JorisBar/555_Synth/555_Synth.kicad_pcb

## KiCad design 555_Synth.kicad_pcb (2025-11-21)

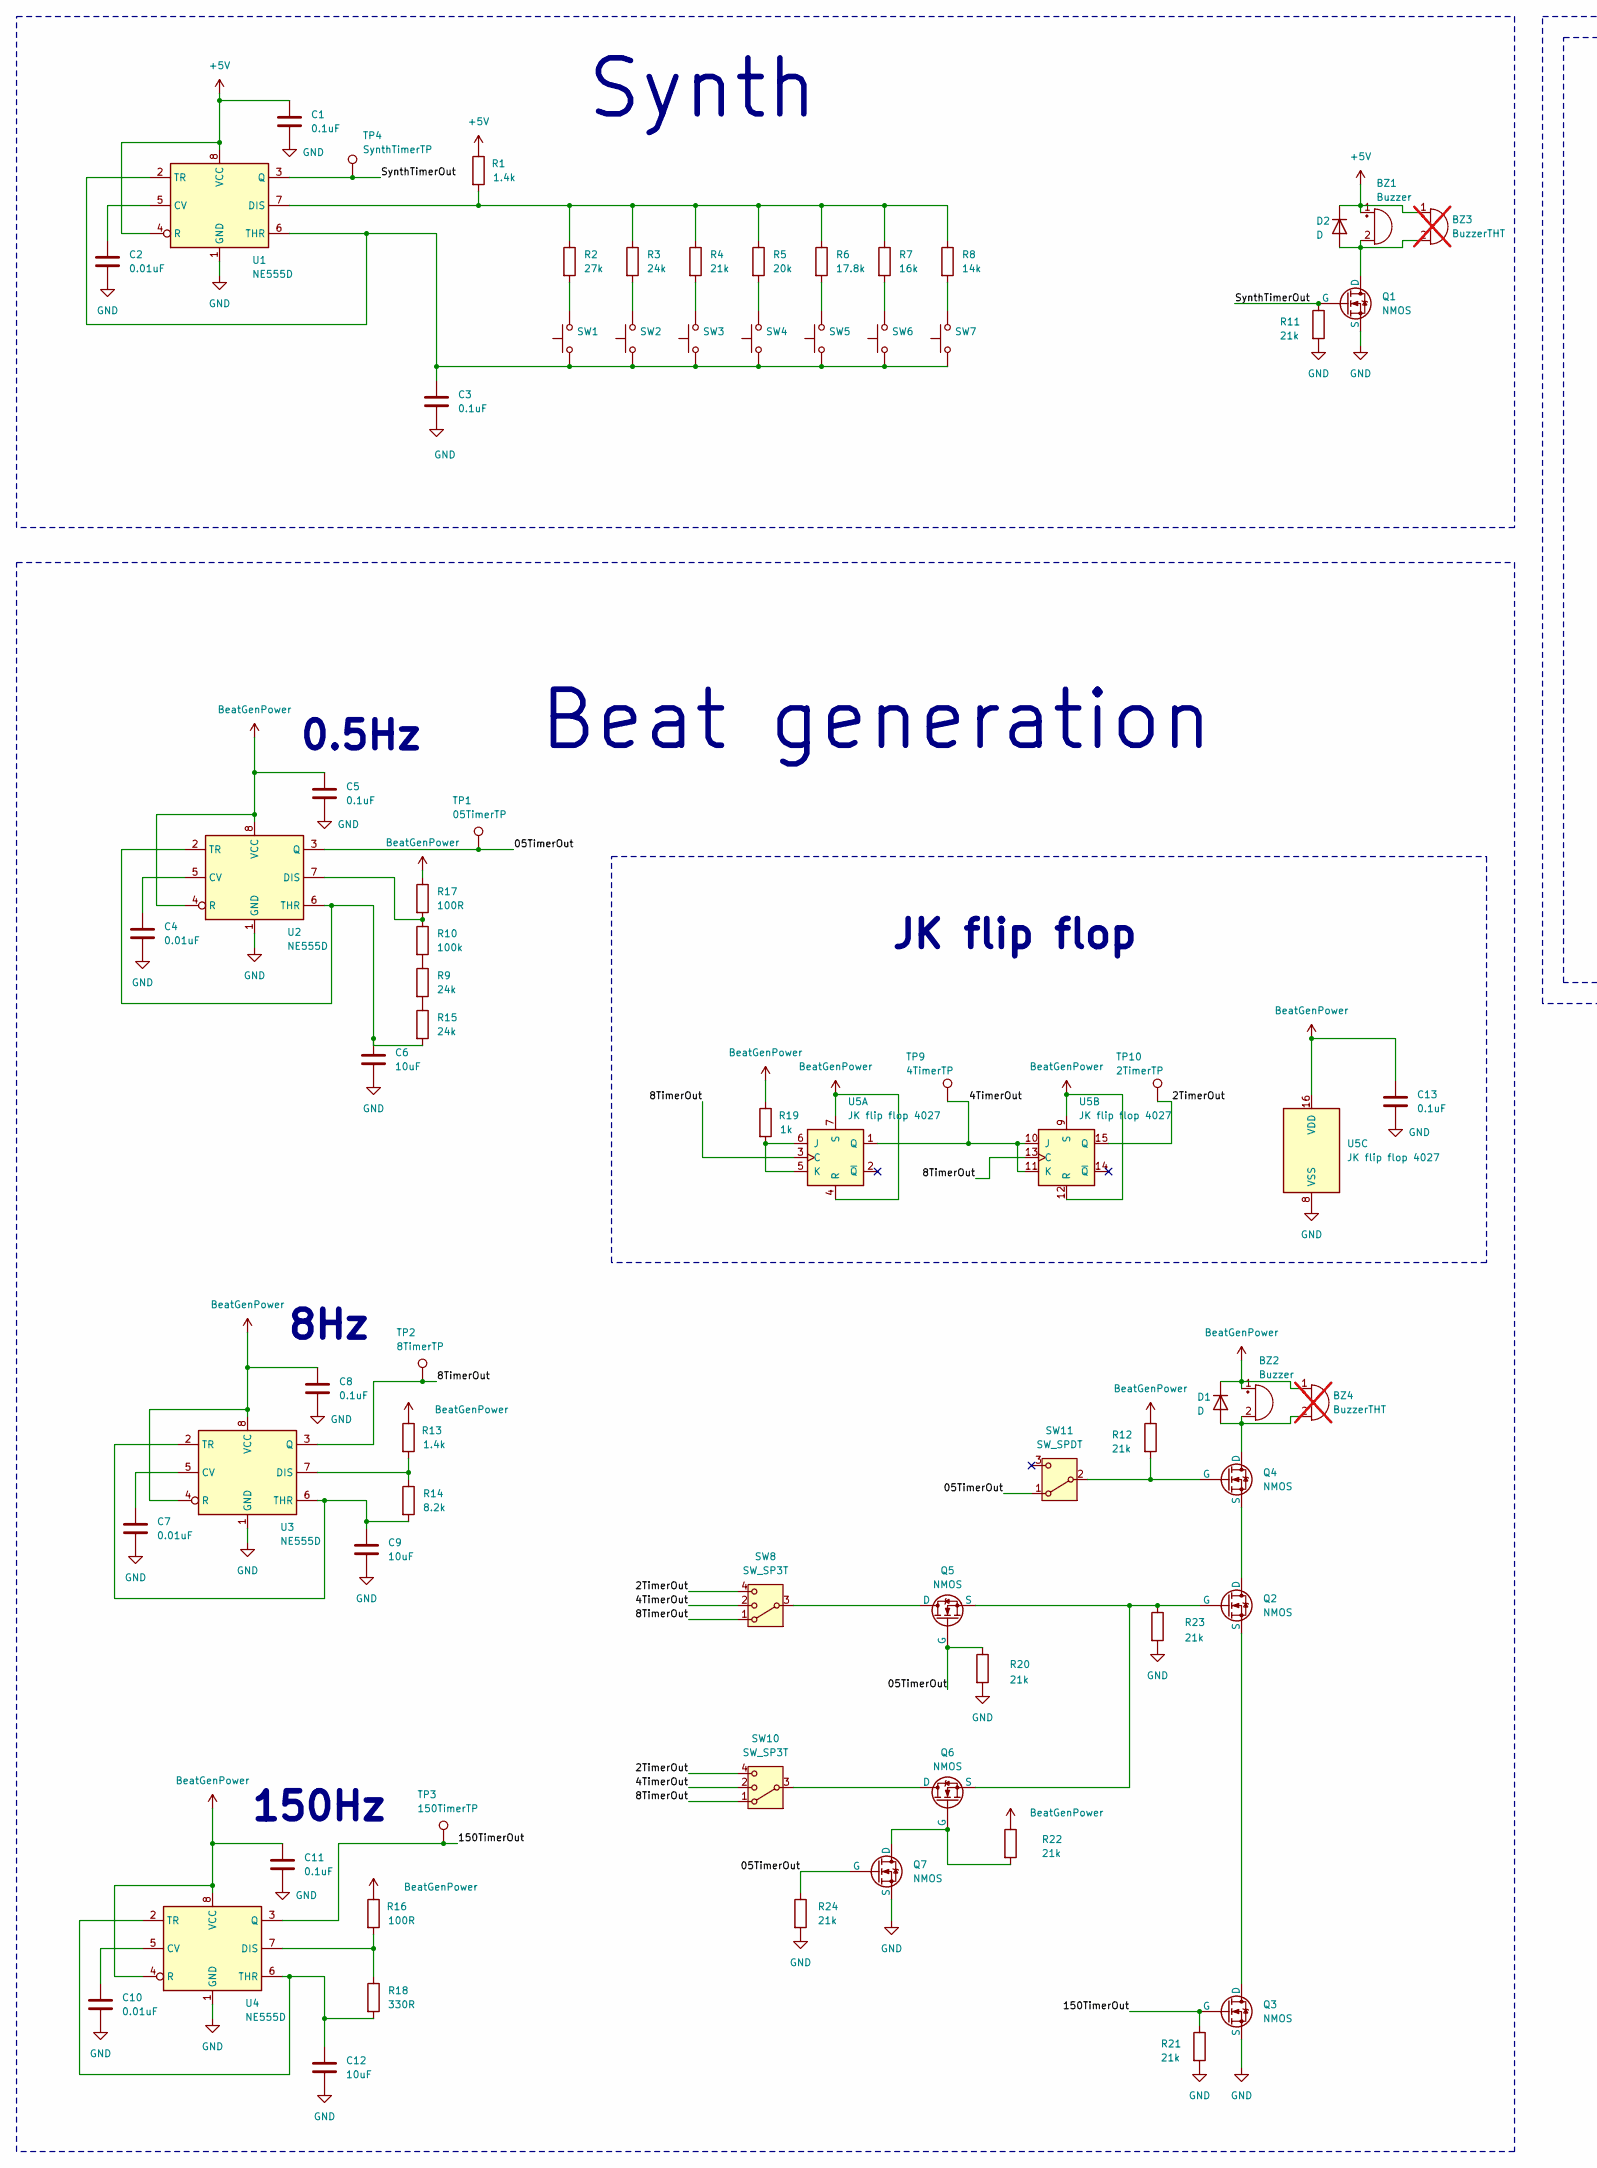
[picture p1: schematic 555_Synth.kicad_sch, part in row 1, column 1]

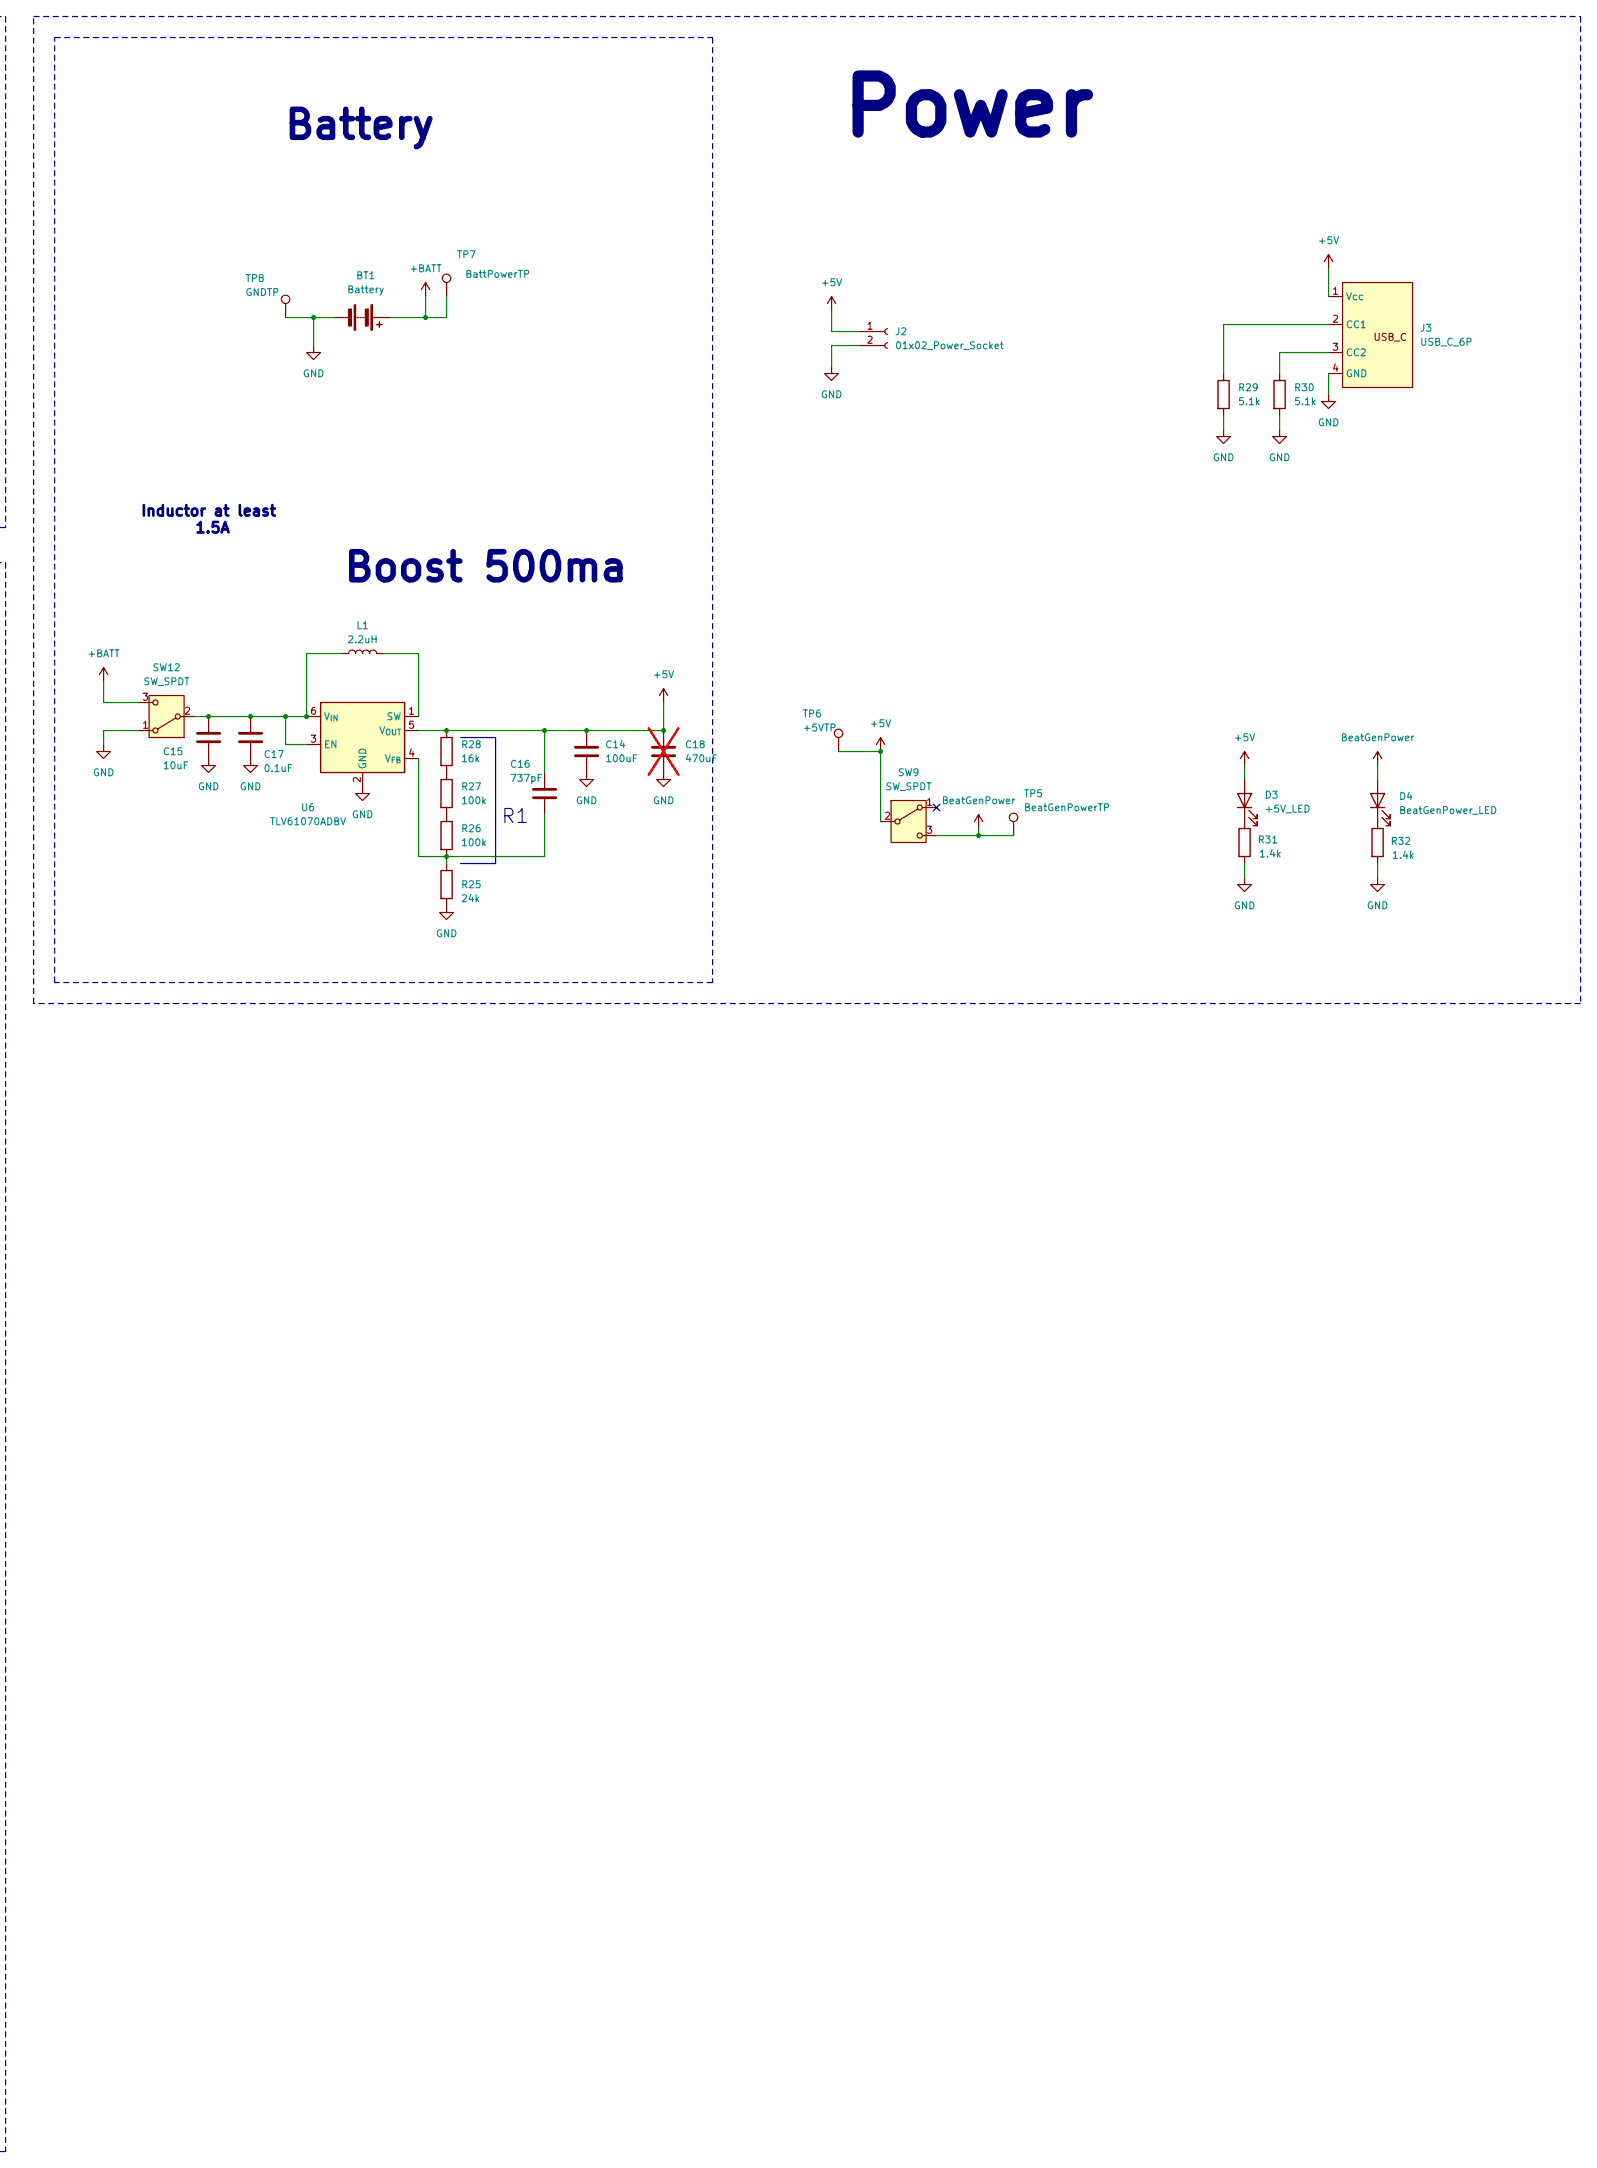
[picture p2: schematic 555_Synth.kicad_sch, part in row 1, column 2]

Parts:
BT1: Battery; Battery holder pad and tension release
BZ1, BZ2: Buzzer; SMD buzzer passive square
BZ3, BZ4: BuzzerTHT; THT buzzer passive round; not fitted
C1, C3, C5, C8, C11, C13, C17: 0.1uF; C_0603_1608Metric_Pad1.08x0.95mm_HandSolder
C2, C4, C7, C10: 0.01uF; C_0603_1608Metric_Pad1.08x0.95mm_HandSolder
C6, C9, C12, C15: 10uF; C_0603_1608Metric_Pad1.08x0.95mm_HandSolder
C14: 100uF; CP_Elec_6.3x7.7
C16: 737pF; C_0603_1608Metric_Pad1.08x0.95mm_HandSolder
C18: 470uF; CP_Elec_8x10.5; not fitted
D1, D2: D; D_SOD-123F
D3: +5V_LED; LED_0603_1608Metric_Pad1.05x0.95mm_HandSolder
D4: BeatGenPower_LED; LED_0603_1608Metric_Pad1.05x0.95mm_HandSolder
J2: 01x02_Power_Socket; PinHeader_1x02_P2.54mm_Vertical
J3: USB_C_6P; USB_C_6P_Connetor
L1: 2.2uH; SMD 3x3.5mm inductor
Q1, Q2, Q3, Q4, Q5, Q6, Q7: NMOS; SOT-23_Handsoldering
R1, R13, R31, R32: 1.4k; R_0603_1608Metric_Pad0.98x0.95mm_HandSolder
R2: 27k; R_0603_1608Metric_Pad0.98x0.95mm_HandSolder
R3, R9, R15, R25: 24k; R_0603_1608Metric_Pad0.98x0.95mm_HandSolder
R4, R11, R12, R20, R21, R22, R23, R24: 21k; R_0603_1608Metric_Pad0.98x0.95mm_HandSolder
R5: 20k; R_0603_1608Metric_Pad0.98x0.95mm_HandSolder
R6: 17.8k; R_0603_1608Metric_Pad0.98x0.95mm_HandSolder
R7, R28: 16k; R_0603_1608Metric_Pad0.98x0.95mm_HandSolder
R8: 14k; R_0603_1608Metric_Pad0.98x0.95mm_HandSolder
R10, R26, R27: 100k; R_0603_1608Metric_Pad0.98x0.95mm_HandSolder
R14: 8.2k; R_0603_1608Metric_Pad0.98x0.95mm_HandSolder
R16, R17: 100R; R_0603_1608Metric_Pad0.98x0.95mm_HandSolder
R18: 330R; R_0603_1608Metric_Pad0.98x0.95mm_HandSolder
R19: 1k; R_0603_1608Metric_Pad0.98x0.95mm_HandSolder
R29, R30: 5.1k; R_0603_1608Metric_Pad0.98x0.95mm_HandSolder
SW1, SW2, SW3, SW4, SW5, SW6, SW7: SW_Push; SW_Push 6x6mm
SW8, SW10: SW_SP3T; SP3T slide switch THT
SW9, SW11, SW12: SW_SPDT; SPDT slide switch THT
TP1: 05TimerTP; TestPoint_Pad_D1.5mm
TP2: 8TimerTP; TestPoint_Pad_D1.5mm
TP3: 150TimerTP; TestPoint_Pad_D1.5mm
TP4: SynthTimerTP; TestPoint_Pad_D1.5mm
TP5: BeatGenPowerTP; TestPoint_Pad_1.5x1.5mm
TP6: +5VTP; TestPoint_Pad_1.5x1.5mm
TP7: BattPowerTP; TestPoint_Pad_1.5x1.5mm
TP8: GNDTP; TestPoint_Pad_1.5x1.5mm
TP9: 4TimerTP; TestPoint_Pad_D1.5mm
TP10: 2TimerTP; TestPoint_Pad_D1.5mm
U1, U2, U3, U4: NE555D; SOIC-8_3.9x4.9mm_P1.27mm
U5: JK flip flop 4027; SOP-16_4.4x10.4mm_P1.27mm
U6: TLV61070ADBV; SOT-23-6

Connections:
+5V: BZ1.1 (+), BZ3.1 (+), C1.1, C14.1, C16.1, C18.1, D2.1 (K), D3.2 (A), J2.1, J3.1 (Vcc), R1.1, R28.1, SW9.2 (B), TP6.1, U1.4 (R), U1.8 (VCC), U6.5 (V_{OUT})
+BATT: BT1.1 (+), SW12.3 (C), TP7.1
/2TimerOut: SW8.4, SW10.4, TP10.1, U5.15 (Q); also elsewhere on the board
/4TimerOut: SW8.2, SW10.2, TP9.1, U5.1 (Q), U5.10 (J), U5.11 (K); also elsewhere on the board
/05TimerOut: Q5.2 (G), Q7.2 (G), R20.1, R24.1, SW11.1 (A), TP1.1, U2.3 (Q); also elsewhere on the board
/8TimerOut: SW8.1, SW10.1, TP2.1, U3.3 (Q), U5.3 (C), U5.13 (C); also elsewhere on the board
/150TimerOut: Q3.2 (G), R21.1, TP3.1, U4.3 (Q); also elsewhere on the board
/SynthTimerOut: Q1.2 (G), R11.1, TP4.1, U1.3 (Q); also elsewhere on the board
BeatGenPower: BZ2.1 (+), BZ4.1 (+), C5.1, C8.1, C11.1, C13.1, D1.1 (K), D4.2 (A), R12.1, R13.1, R16.1, R17.1, R19.1, R22.1, SW9.3 (C), TP5.1, U2.4 (R), U2.8 (VCC), U3.4 (R), U3.8 (VCC), U4.4 (R), U4.8 (VCC), U5.4 (R), U5.7 (S), U5.9 (S), U5.12 (R), U5.16 (VDD)
GND: BT1.2 (-), C1.2, C2.2, C3.2, C4.2, C5.2, C6.2, C7.2, C8.2, C9.2, C10.2, C11.2, C12.2, C13.2, C14.2, C15.2, C17.2, C18.2, J2.2, J3.4 (GND), Q1.3 (S), Q3.3 (S), Q7.3 (S), R11.2, R20.2, R21.2, R23.2, R24.2, R25.2, R29.2, R30.2, R31.2, R32.2, SW12.1 (A), TP8.1, U1.1 (GND), U2.1 (GND), U3.1 (GND), U4.1 (GND), U5.8 (VSS), U6.2 (GND)
unnamed: BZ1.2 (-), BZ3.2 (-), D2.2 (A), Q1.1 (D)
unnamed: BZ2.2 (-), BZ4.2 (-), D1.2 (A), Q4.1 (D)
unnamed: D3.1 (K), R31.1
unnamed: D4.1 (K), R32.1
unnamed: J3.2 (CC1), R29.1
unnamed: J3.3 (CC2), R30.1
unnamed: Q2.1 (D), Q4.3 (S)
unnamed: Q2.2 (G), Q5.3 (S), Q6.3 (S), R23.1
unnamed: Q2.3 (S), Q3.1 (D)
unnamed: Q4.2 (G), R12.2, SW11.2 (B)
unnamed: Q5.1 (D), SW8.3
unnamed: Q6.1 (D), SW10.3
unnamed: Q6.2 (G), Q7.1 (D), R22.2
unnamed: R2.2, SW1.2
unnamed: R3.2, SW2.2
unnamed: R4.2, SW3.2
unnamed: R5.2, SW4.2
unnamed: R6.2, SW5.2
unnamed: R7.2, SW6.2
unnamed: R8.2, SW7.2
unnamed: R9.1, R10.2
unnamed: R9.2, R15.1
unnamed: R26.1, R27.2
unnamed: R27.1, R28.2
unnamed: C15.1, C17.1, L1.1, SW12.2 (B), U6.3 (EN), U6.6 (V_{IN})
unnamed: C2.1, U1.5 (CV)
unnamed: R1.2, R2.1, R3.1, R4.1, R5.1, R6.1, R7.1, R8.1, U1.7 (DIS)
unnamed: C3.1, SW1.1, SW2.1, SW3.1, SW4.1, SW5.1, SW6.1, SW7.1, U1.2 (TR), U1.6 (THR)
unnamed: C4.1, U2.5 (CV)
unnamed: R10.1, R17.2, U2.7 (DIS)
unnamed: C6.1, R15.2, U2.2 (TR), U2.6 (THR)
unnamed: C7.1, U3.5 (CV)
unnamed: R13.2, R14.1, U3.7 (DIS)
unnamed: C9.1, R14.2, U3.2 (TR), U3.6 (THR)
unnamed: C10.1, U4.5 (CV)
unnamed: R16.2, R18.1, U4.7 (DIS)
unnamed: C12.1, R18.2, U4.2 (TR), U4.6 (THR)
unnamed: R19.2, U5.5 (K), U5.6 (J)
unnamed: L1.2, U6.1 (SW)
unnamed: C16.2, R25.1, R26.2, U6.4 (V_{FB})

Notes on the sheet:
8Hz
0.5Hz
Beat generation
Synth
Boost 500ma
Battery
150Hz
Power
JK flip flop
Inductor at least 1.5A

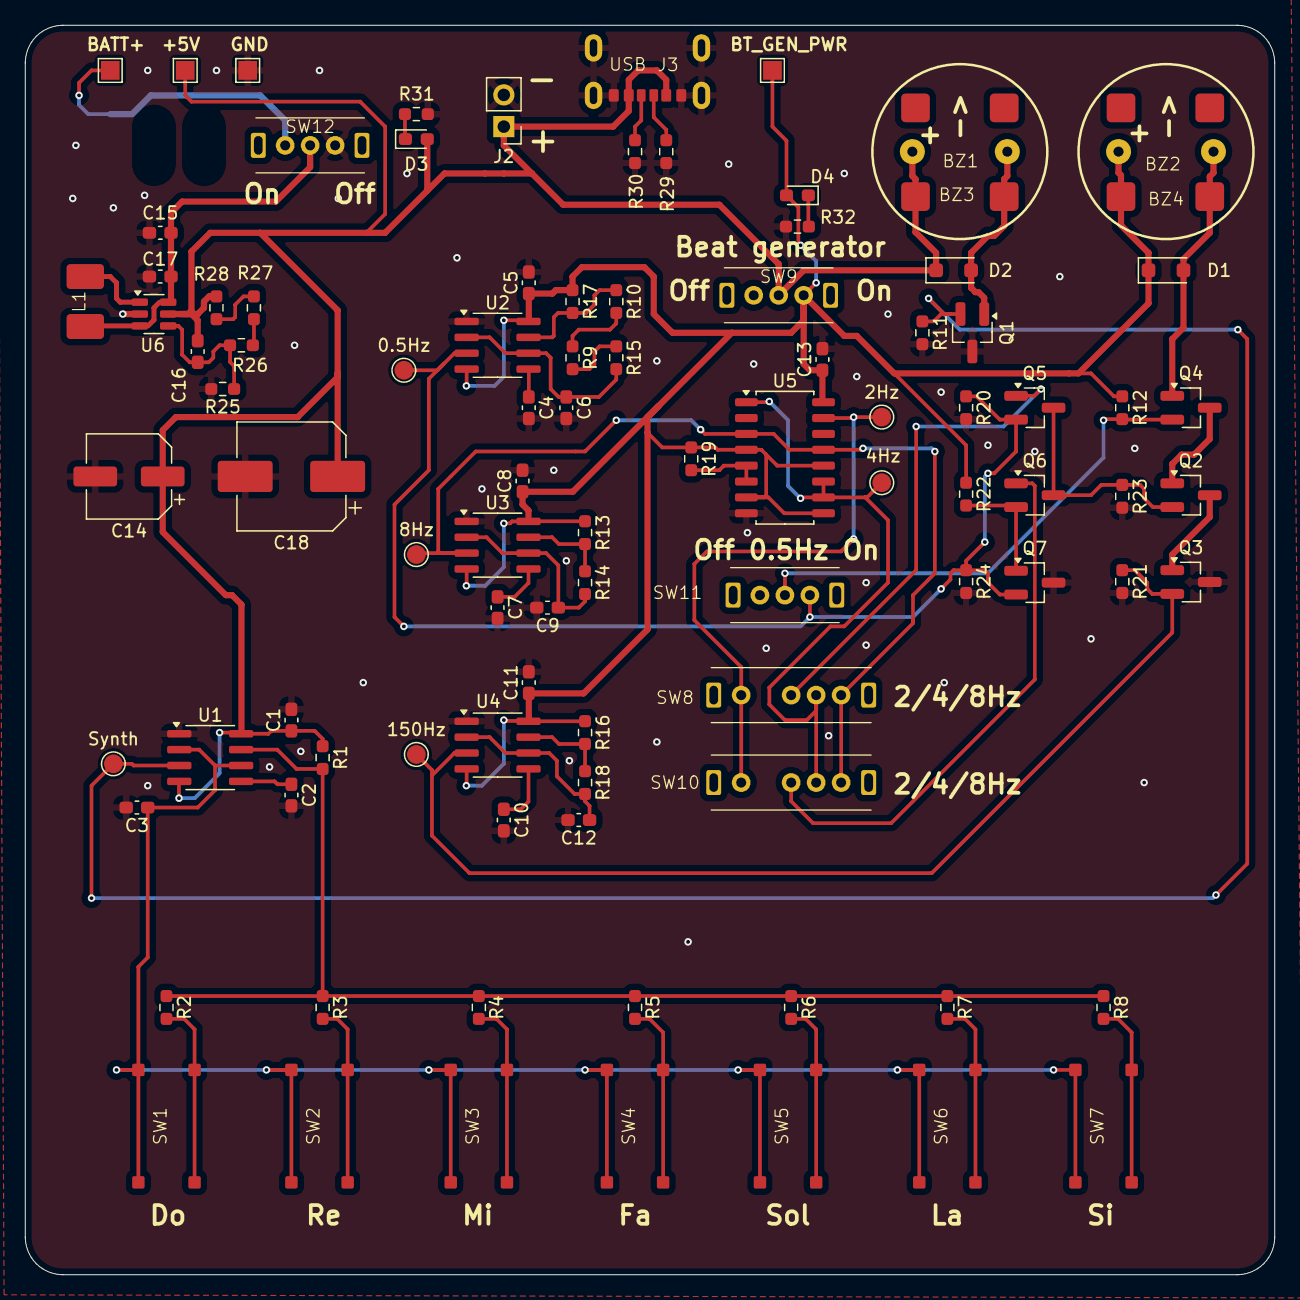
[picture p3: board 555_Synth.kicad_pcb from above]

Board: 2 copper layers, 100.0 x 100.0 mm, 97 parts (1 on the bottom side), 50 nets.

Other parts of the board:
0.5Hz: 05TimerTP; TestPoint_Pad_D1.5mm
2Hz: 2TimerTP; TestPoint_Pad_D1.5mm
4Hz: 4TimerTP; TestPoint_Pad_D1.5mm
8Hz: 8TimerTP; TestPoint_Pad_D1.5mm
150Hz: 150TimerTP; TestPoint_Pad_D1.5mm
Synth: SynthTimerTP; TestPoint_Pad_D1.5mm

Their connections:
/2TimerOut: 2Hz.1; also elsewhere on the board
/4TimerOut: 4Hz.1; also elsewhere on the board
/05TimerOut: 0.5Hz.1; also elsewhere on the board
/8TimerOut: 8Hz.1; also elsewhere on the board
/150TimerOut: 150Hz.1; also elsewhere on the board
/SynthTimerOut: Synth.1; also elsewhere on the board
